Giannix00/IHP__TEST6967/README.md

# IHP__TEST6967: 130-GHz Passive Test Chip in IHP SG13CMOS5L

Chip design data for the IHP Open-Silicon MPW run Nov-2026 (SG13CMOS5L, run 877). The chip is purely passive
(no devices, no supply). Layout and verification were made with open-source tools (IHP-Open-PDK, KLayout, Magic, gdscheck).

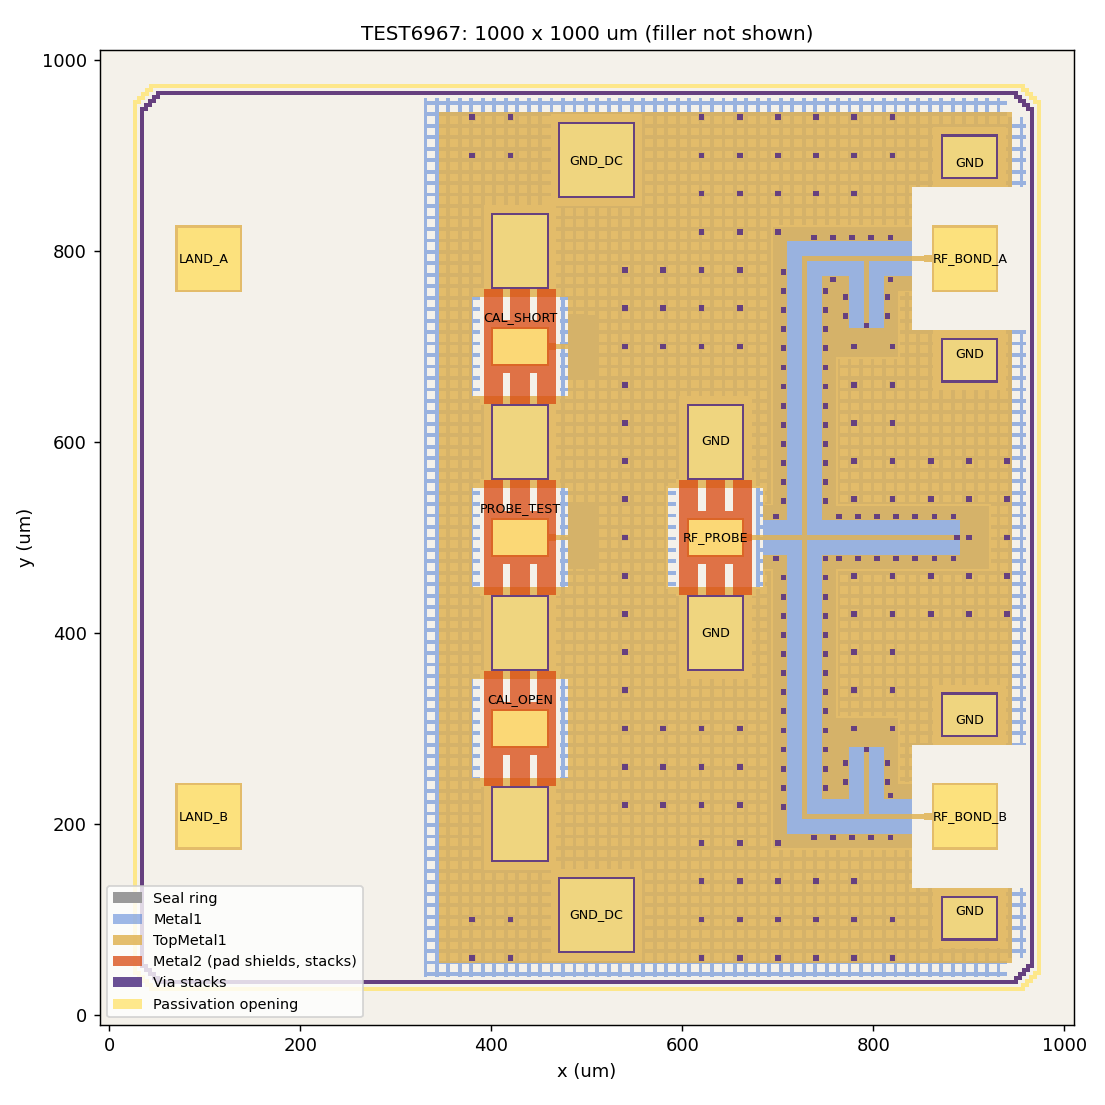
[picture p1: doc/TEST6967.png]
Layout


| | |
|---|---|
| Top cell | `TEST6967` |
| Category | Analog / TEST (test and characterisation structure) |
| Die size | 1000 x 1000 um (1.0 mm²), seal ring and filler included |
| Technology | IHP SG13CMOS5L (Metal1 ... TopMetal1), IHP-Open-PDK `c6562037` |
| Frequency range | D-band, centre 130 GHz |
| Release | [`release/v.1.0.0/gds/TEST6967.gds`](release/v.1.0.0/gds/TEST6967.gds), SHA-256 in [`SHA256SUMS`](release/v.1.0.0/gds/SHA256SUMS) |
| Sign-off | [`release/v.1.0.0/doc/Signoff.md`](release/v.1.0.0/doc/Signoff.md) |

## Structures

- **RF_PROBE**: GSG probe pad (100-um pitch) at x = 634.82 um, y = 500 um, probed from the left (-x).
- **On-chip network**: TopMetal1 lines over Metal1 ground from RF_PROBE to the two RF pads **RF_BOND_A** and
  **RF_BOND_B** at the right chip edge, each with two ground pads.
- **Calibration structures** in the ground plate at x = 430 um, GSG with 100-um pitch, probed from the left:
  **CAL_OPEN** and **CAL_SHORT**. They use the same pad geometry, Metal2 pad shield and ground window as RF_PROBE.
- **PROBE_TEST**: signal pad between CAL_OPEN and CAL_SHORT at y = 500 um, shorted like CAL_SHORT, for probe landing
  and contact tests. It uses the neighbouring ground pads of CAL_OPEN and CAL_SHORT.
- **LAND_A, LAND_B**: floating TopMetal1 pads at the left chip edge, the mirror image of RF_BOND_A and RF_BOND_B in x, as
  landing pads for wires from a neighbouring chip.
- **GND_DC**: two ground pads (top and bottom).
- Ground: TopMetal1 plate with slits from x = 345 um to the right chip edge, Metal1 grid below (not below the pad
  shields), via stacks Metal1 to TopMetal1 on a 40-um grid. Left of the plate the chip holds LAND_A, LAND_B and PDK
  filler.
- **Metal2 pad shield** below the signal pads of RF_PROBE, CAL_OPEN, CAL_SHORT and PROBE_TEST: covers the pad with 8 um
  margin and joins the two ground pads with three 20-um strips per side, so that the pad capacitance ends on the local
  ground and OPEN/SHORT de-embedding removes the pad. No Metal1 grid below the shield.

Pad positions and sizes: [doc/Datasheet.md](doc/Datasheet.md).

## Repository contents

| Path | Content |
|---|---|
| `doc/` | `info.json`, specification, datasheet, TRL self-assessment, layout figure |
| `release/v.1.0.0/gds/` | final GDS (seal ring and filler included) and checksum |
| `release/v.1.0.0/netlist/` | LVS netlist (empty subcircuit: the chip has no devices) |
| `release/v.1.0.0/doc/` | DRC and LVS logs and result databases, sign-off summary |
| `measurements/v.1.0.0/` | measurement results (after fabrication) |
| `TEST6967-main/` | layout generator and build flow of the top cell, rebuild instructions |
| `dependencies/` | none |
| `.github/workflows/` | workflow-sync template of Open-Silicon-MPW, as created by `gen_structure.py` |

## License

Apache License 2.0, see [LICENSE](LICENSE).

## Author

Gianluca Simone, Institute for Smart Electronics and Systems (LITES), Friedrich-Alexander-Universität
Erlangen-Nürnberg (FAU), Germany.
