Giannix00/IHP__TEST6967/measurements/v.1.0.0/README.md

# Measurements, TEST6967 v.1.0.0

Measurement results will be added here after fabrication.
