Giannix00/IHP__TEST6967/(commit log)

2026-10-30 TEST6967 v.1.0.0: release for Open-Silicon MPW Nov-2026 (SG13CMOS5L)
    Purely passive 130-GHz test chip, 1000 x 1000 um incl. seal ring and filler.
    Release GDS, empty LVS netlist, DRC (full incl. antenna, minimum/precheck),
    Magic DRC and LVS evidence, info.json, datasheet, specification, TRL.
2026-11-06 TEST6967 v.1.0.0: final GDS with probe test and landing pads
    Replaces the release GDS. Layout changes:
    - Metal1 grid stays clear of the seal ring corners.
    - 2-um Metal1 gap between the corridor below the lines and the grid (slit density).
    - PROBE_TEST pad for probe landing and contact tests.
    - Floating landing pads LAND_A and LAND_B at the left chip edge.
    DRC (full incl. antenna, flat, minimum/precheck), Magic DRC, LVS and gdscheck evidence of
    this file and the result of the IHP online tape-in check are in release/v.1.0.0/doc/Signoff.md.
    Layout generator and flow added under TEST6967-main/layout/klayout/scripts/.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
2026-11-07 TEST6967 v.1.0.0: Metal2 pad shield below the probe-side signal pads
    The signal pads of RF_PROBE, CAL_OPEN, CAL_SHORT and PROBE_TEST get a Metal2
    shield (pad plus 8 um, three 20-um strips per side into the ground pads, no
    Metal1 grid below). RF_PROBE and the two standards then carry the same pad, so
    OPEN/SHORT de-embedding removes it.
    - Generator: build_core.py --m2_shield 8, flow.sh updated.
    - Release GDS sha256 ece14230fd5ddc5bfea09b44cf251c4cdafabb0805406b5e70a856e70a369ff3.
    Compared with the previous release only Metal1, Metal2 and the Metal2 filler differ.
    - Evidence rerun on the release file (2026-11-07): KLayout DRC full incl. antenna,
    minimum and flat, LVS, Magic DRC and gdschec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
2026-11-07 README: PROBE_TEST bullet names its neighbours, pad shield after the ground bullet
2026-11-07 TEST6967 v.1.0.0: shield strips end on the ground pad edge (Pad.eR_M2)
    The outer Metal2 shield strips stuck out 8 um beside the ground pads and reached 1 um into them. Each overlap left
    a 1-um Metal2 exit edge at the pad side, which the IHP online check reported as Pad.eR_M2 (recommended exit width
    7 um, 16 times). The strips now end on the pad edge, and only their part within the pad overlaps it.
    Release GDS (sha256 7d3c4f6d8a55f32d4782d62112d1f959134d386959e32dff0d1361fadfde6cfd), checksum, evidence, layout
    picture and the online check in Signoff.md are updated. The rebuild from the generator is identical.
